deionizedoatmeal/dittokeeb/mechanical/keyboard-layout.png

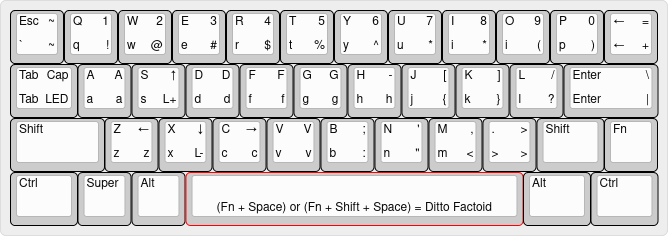
mechanical/keyboard-layout.png
