deionizedoatmeal/dittokeeb/mechanical/STLs/top_full.stl

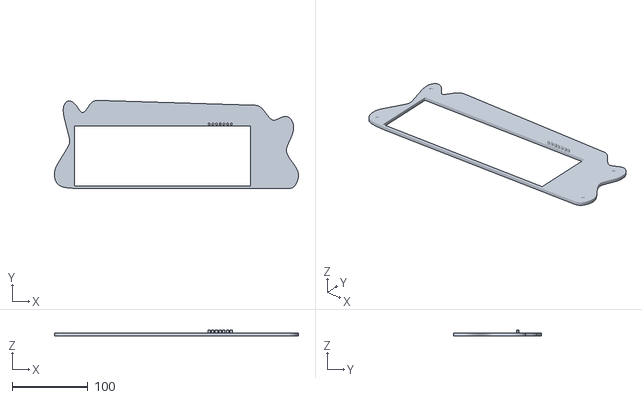
[picture p2: CAD file, 2022-06-20]
mechanical/STLs/top_full.stl
321.8 x 116.4 x 7.50
