deionizedoatmeal/dittokeeb/mechanical/STLs/case_full.stl

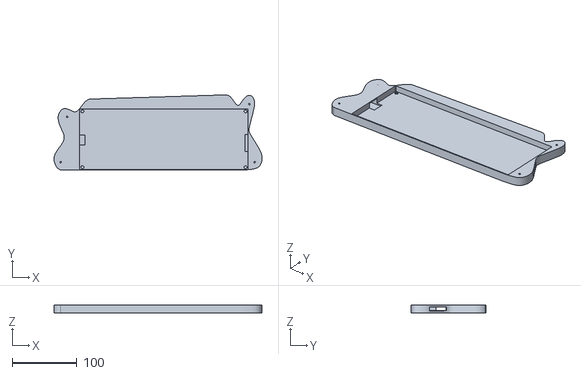
[picture p3: CAD file, 2022-06-17]
mechanical/STLs/case_full.stl
321.8 x 116.4 x 12.0
