deionizedoatmeal/dittokeeb/mechanical/STLs/top_right.stl

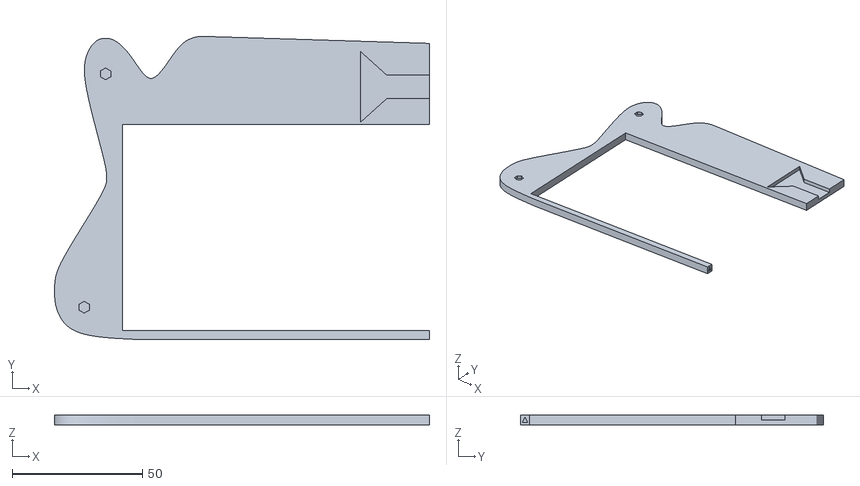
[picture p4: CAD file, 2022-06-22]
mechanical/STLs/top_right.stl
143.9 x 116.4 x 4.00
