deionizedoatmeal/dittokeeb/mechanical/STLs/top_left.stl

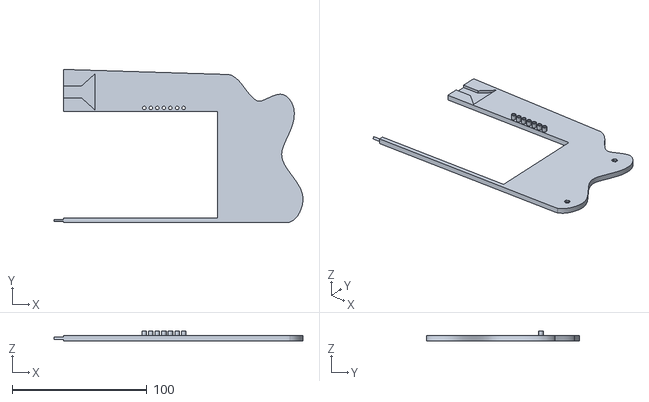
[picture p5: CAD file, 2022-06-22]
mechanical/STLs/top_left.stl
184.8 x 113.7 x 7.50
