deionizedoatmeal/dittokeeb/mechanical/STLs/ditto_key_1.75u.stl

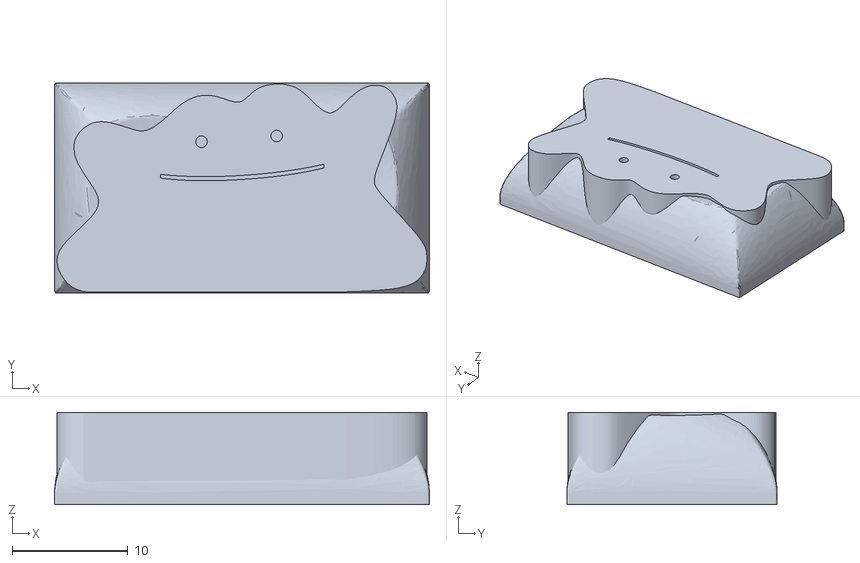
[picture p6: CAD file, 2022-06-20]
mechanical/STLs/ditto_key_1.75u.stl
32.5 x 18.2 x 8.00
