deionizedoatmeal/dittokeeb/mechanical/STLs/case_left.stl

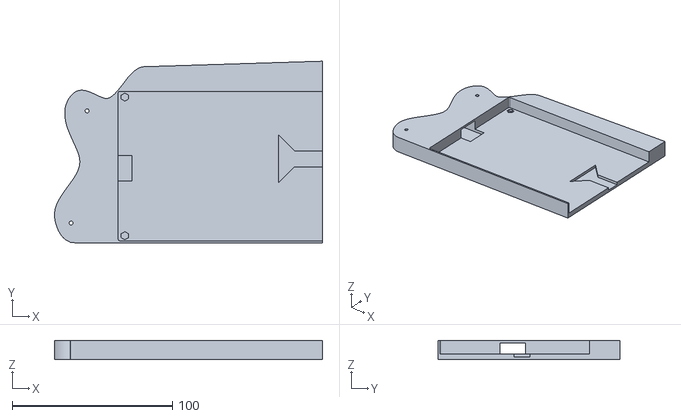
[picture p7: CAD file, 2022-06-17]
mechanical/STLs/case_left.stl
167.3 x 113.4 x 12.0
