deionizedoatmeal/dittokeeb/mechanical/STLs/case_right.stl

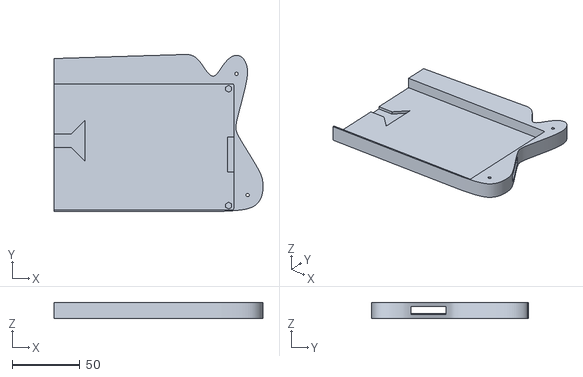
[picture p8: CAD file, 2022-06-17]
mechanical/STLs/case_right.stl
154.8 x 116.4 x 12.0
