deionizedoatmeal/dittokeeb/mechanical/STLs/plate_right.stl

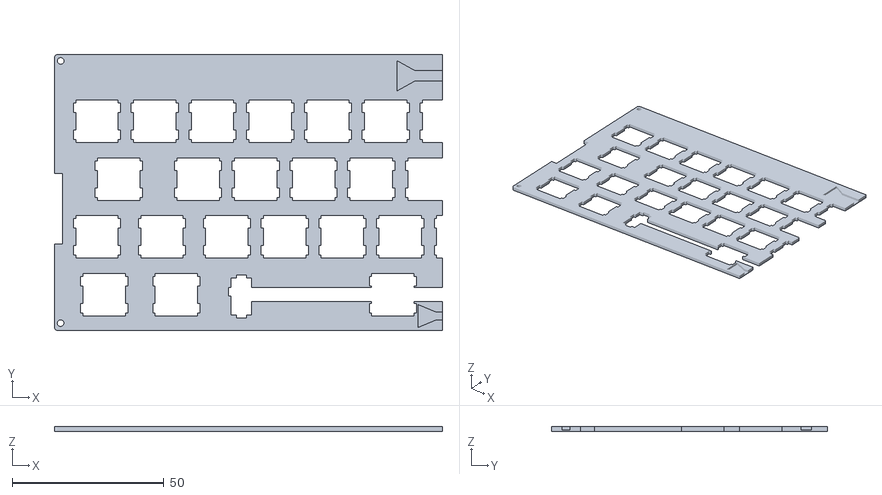
[picture p9: CAD file, 2022-06-07]
mechanical/STLs/plate_right.stl
128.0 x 91.0 x 1.50
