deionizedoatmeal/dittokeeb/mechanical/STLs/plate_left.stl

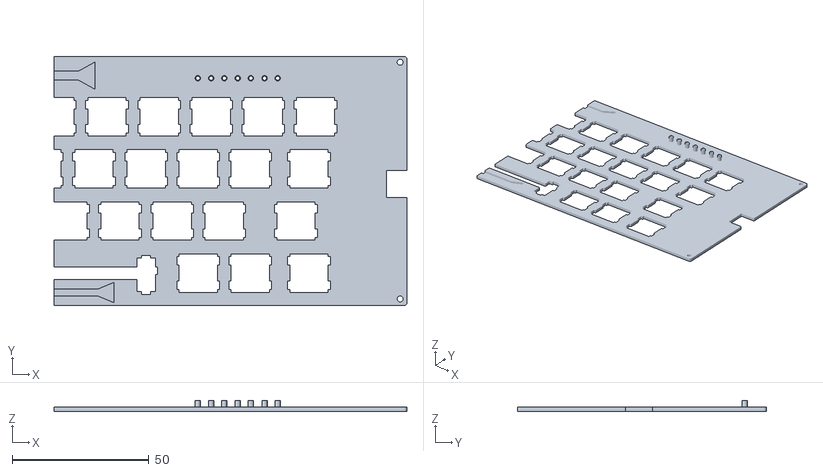
[picture p10: CAD file, 2022-06-07]
mechanical/STLs/plate_left.stl
129.0 x 91.0 x 3.90
