deionizedoatmeal/dittokeeb/mechanical/STLs/case_connector.stl

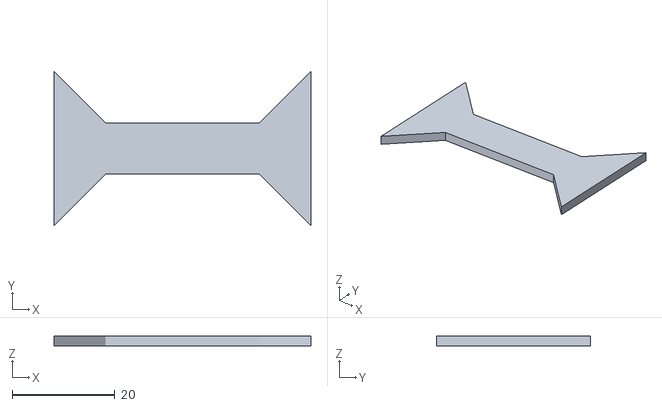
[picture p11: CAD file, 2022-06-07]
mechanical/STLs/case_connector.stl
50.0 x 30.0 x 2.00
