deionizedoatmeal/dittokeeb/mechanical/STLs/plate_connectors.stl

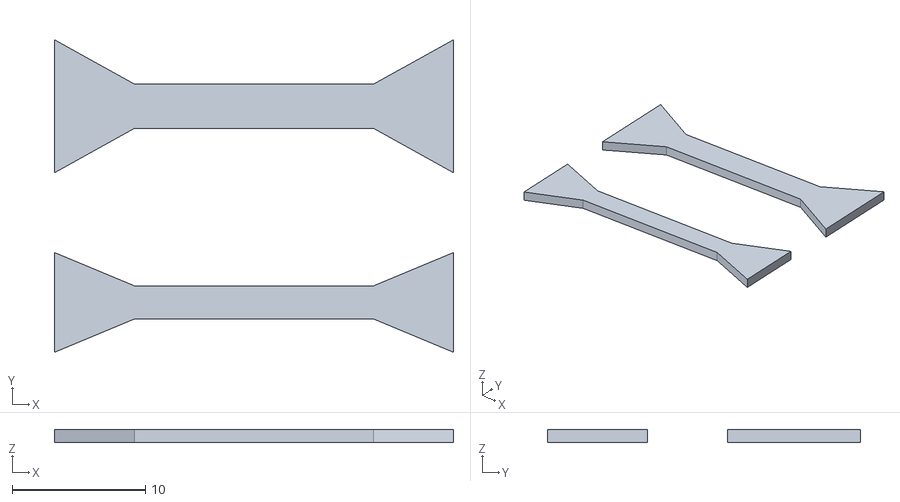
[picture p12: CAD file, 2022-06-07]
mechanical/STLs/plate_connectors.stl
30.0 x 23.5 x 1.00
