deionizedoatmeal/dittokeeb/(list of files, cad)

Other CAD files:
mechanical/STLs/top_connector.stl
