deionizedoatmeal/dittokeeb/electrical/PDFs/schematic.pdf

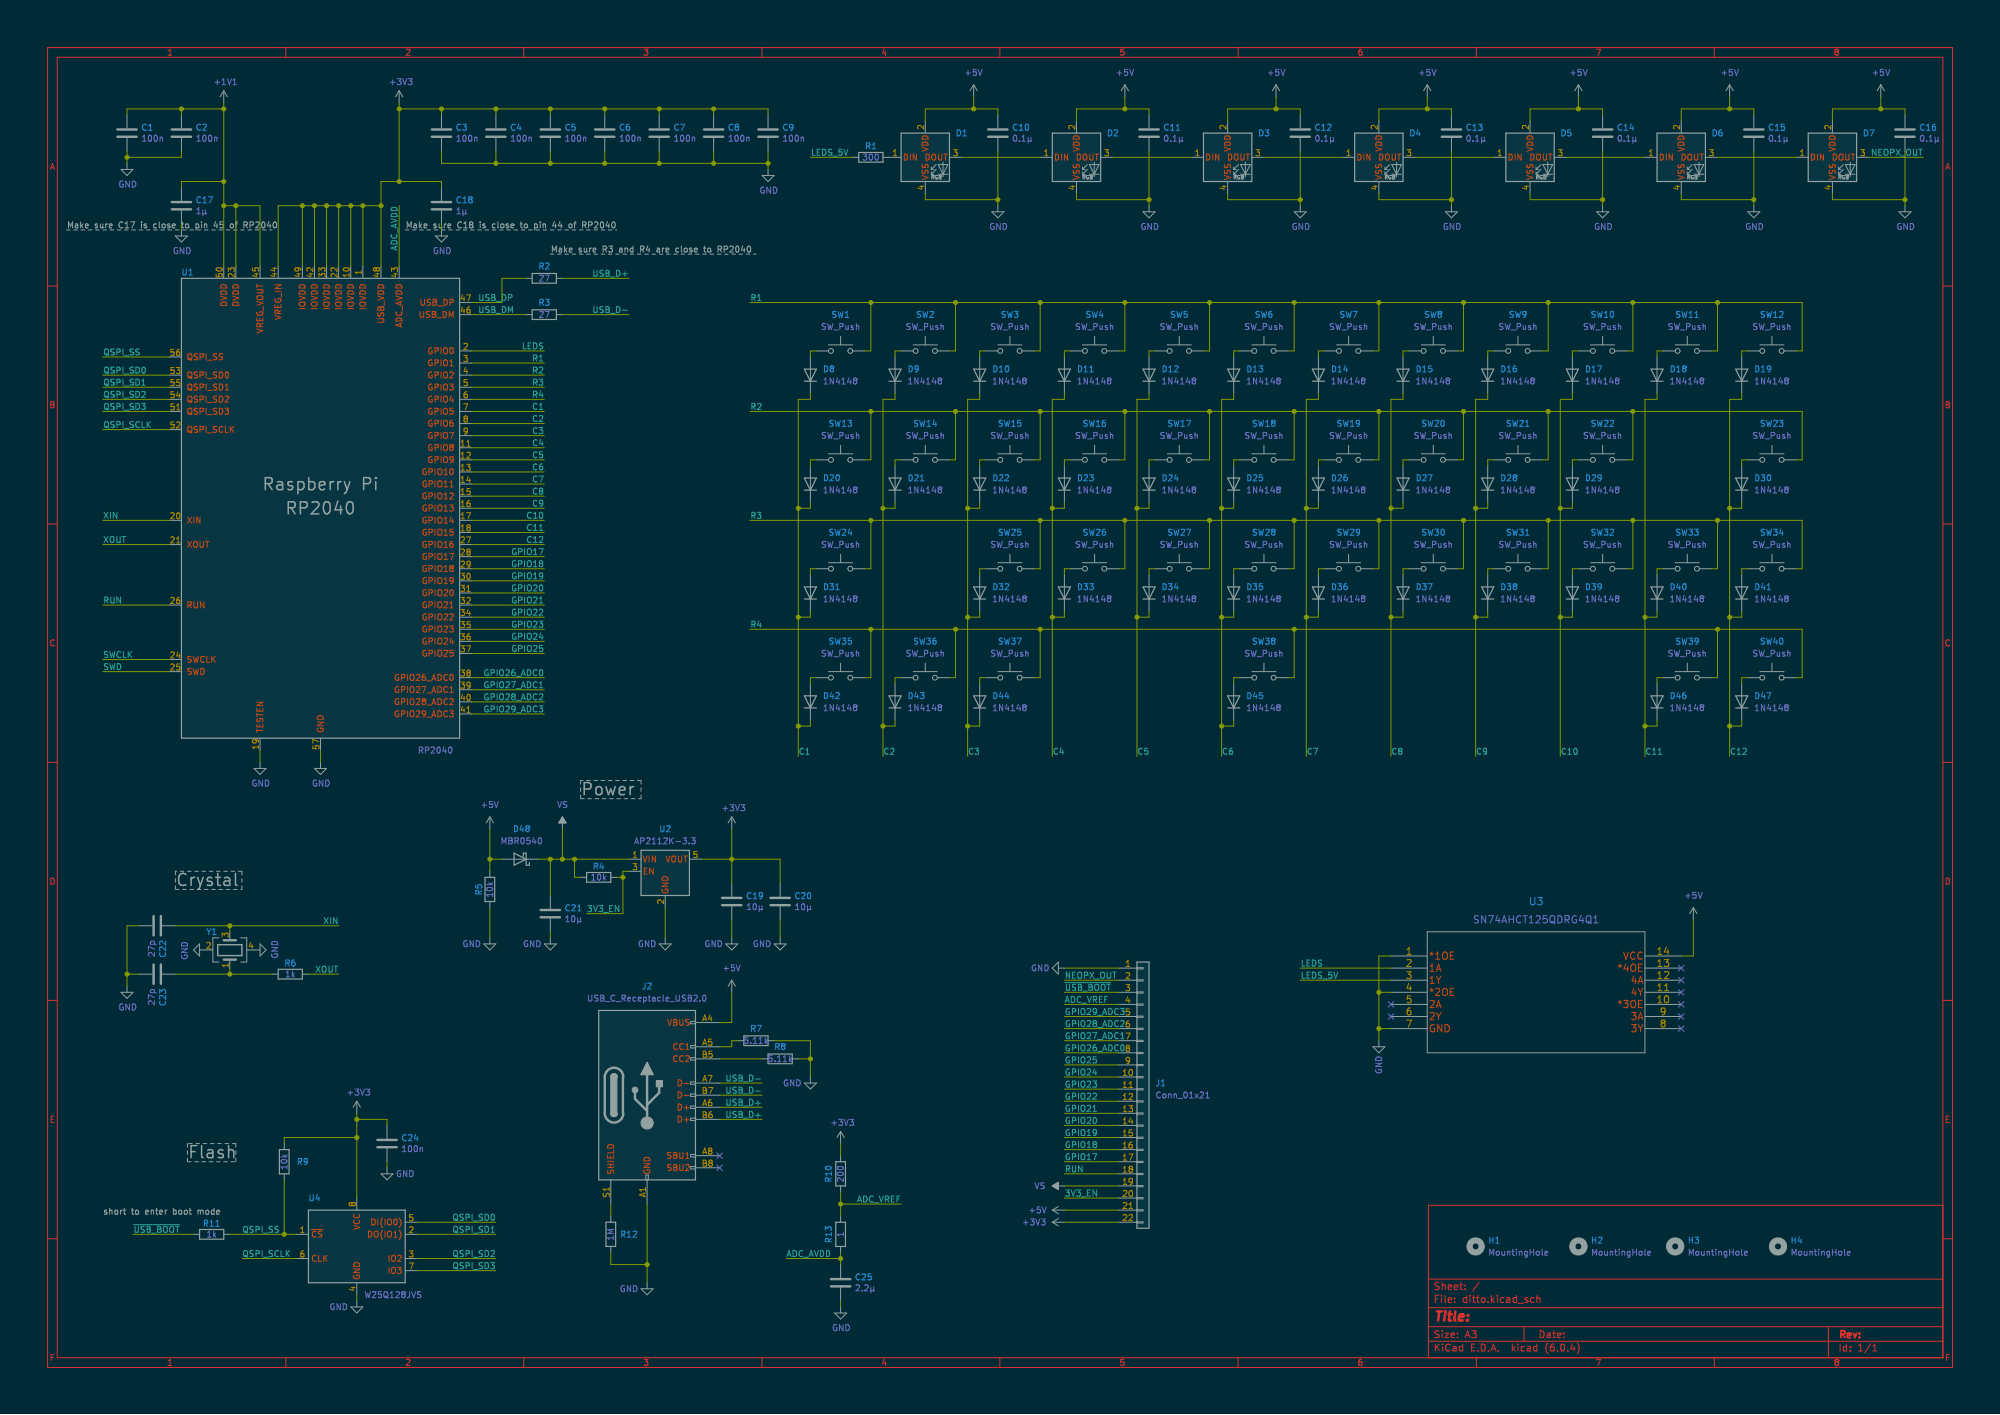
[picture p13: page 1]
