deionizedoatmeal/dittokeeb/electrical/PDFs/pcb.pdf

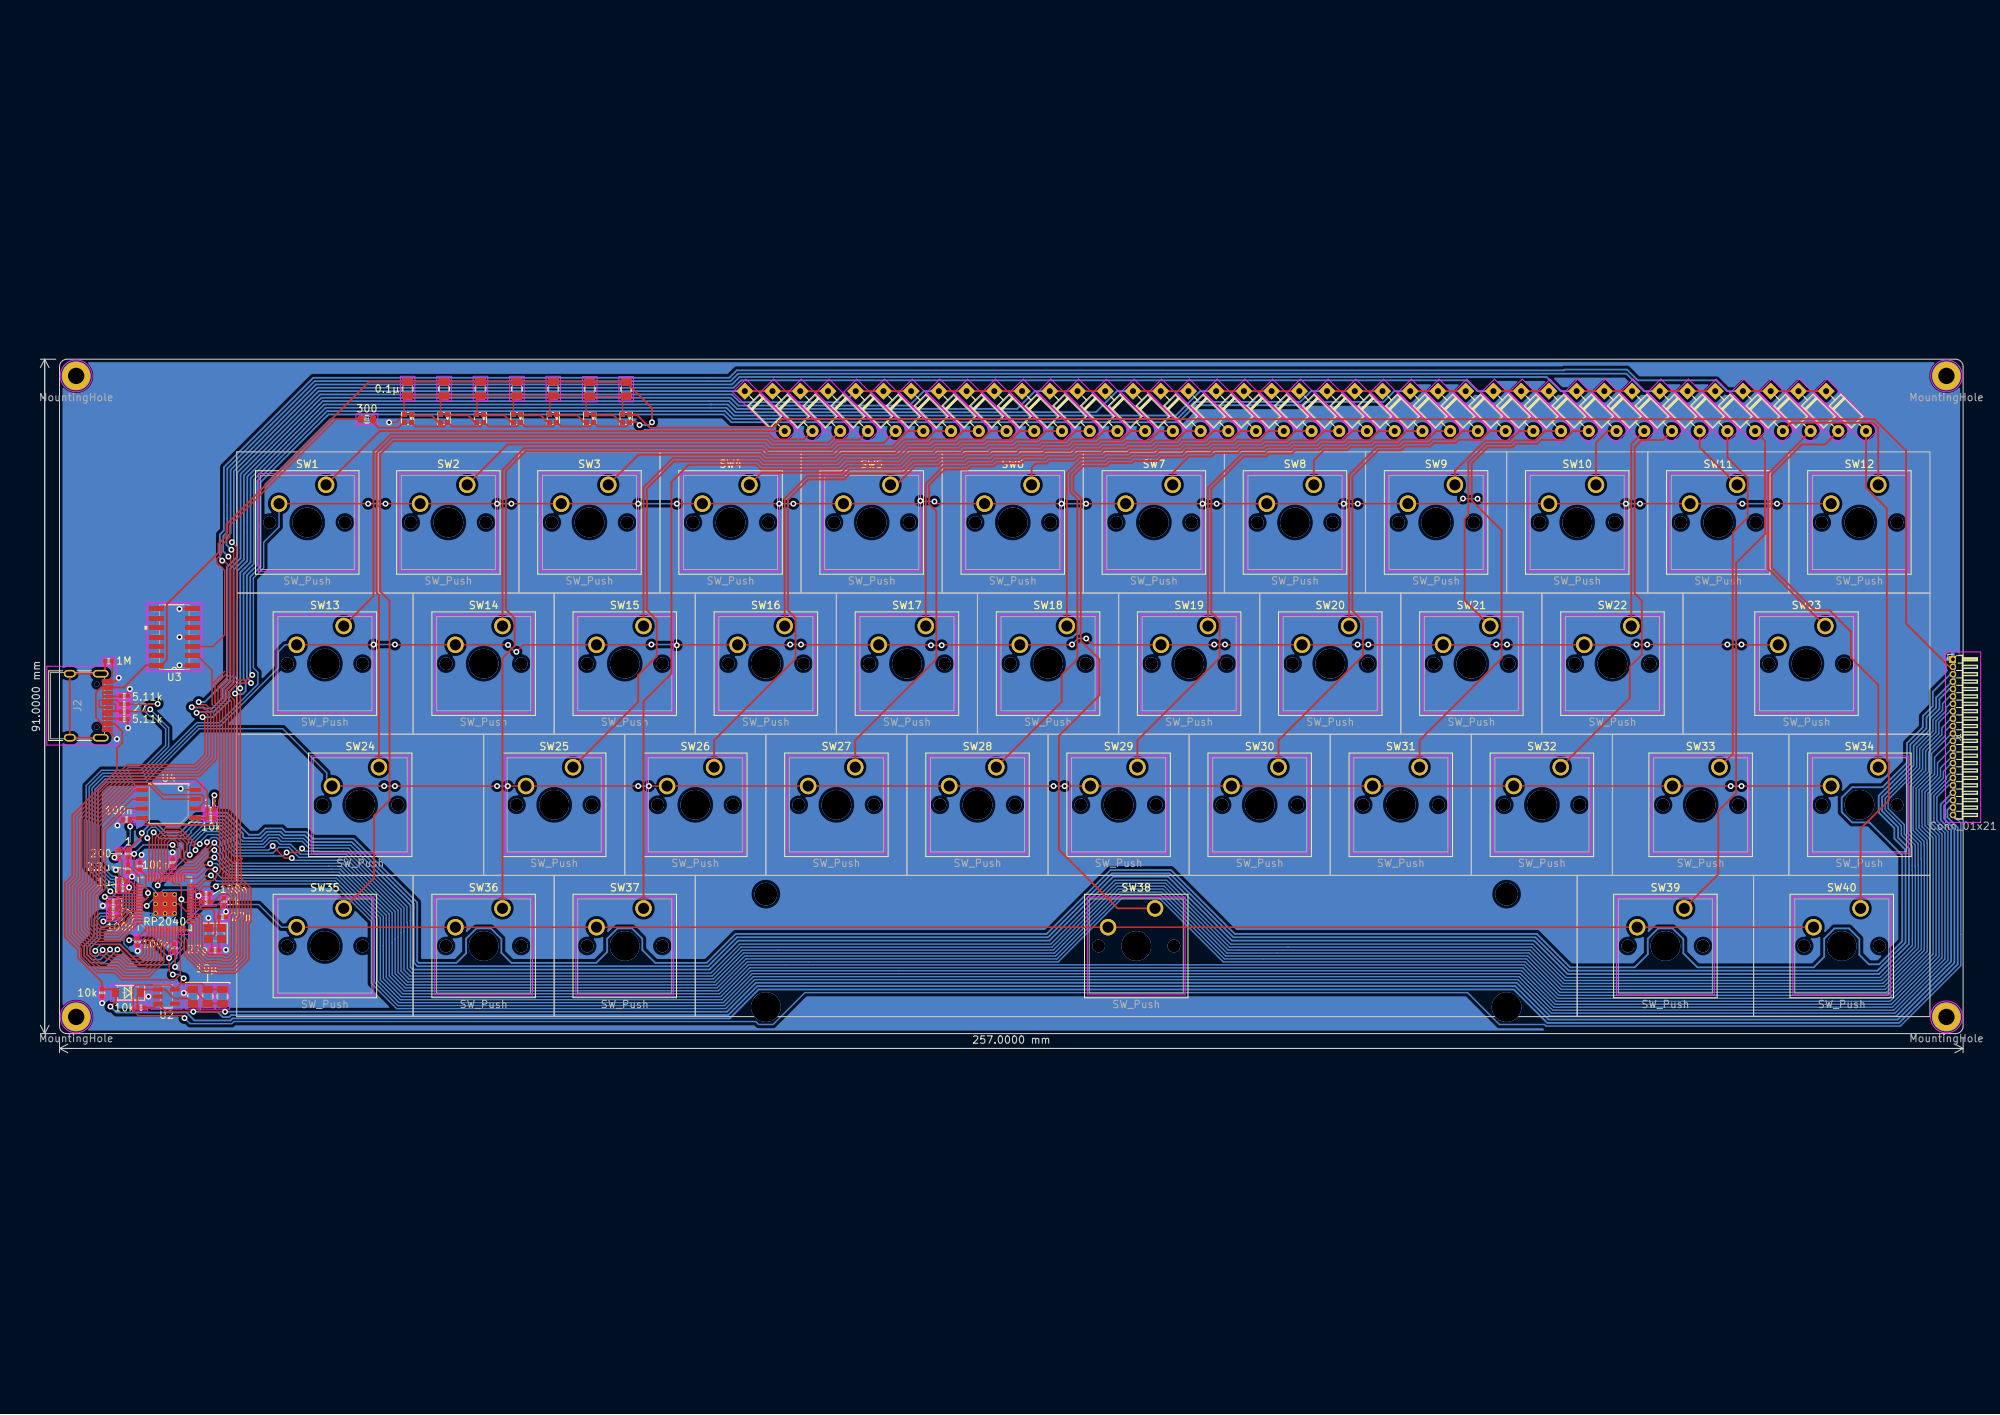
[picture p14: page 1]
