deionizedoatmeal/dittokeeb/electrical/ditto.kicad_pcb

## KiCad design electrical/ditto.kicad_pcb (2022-06-09)

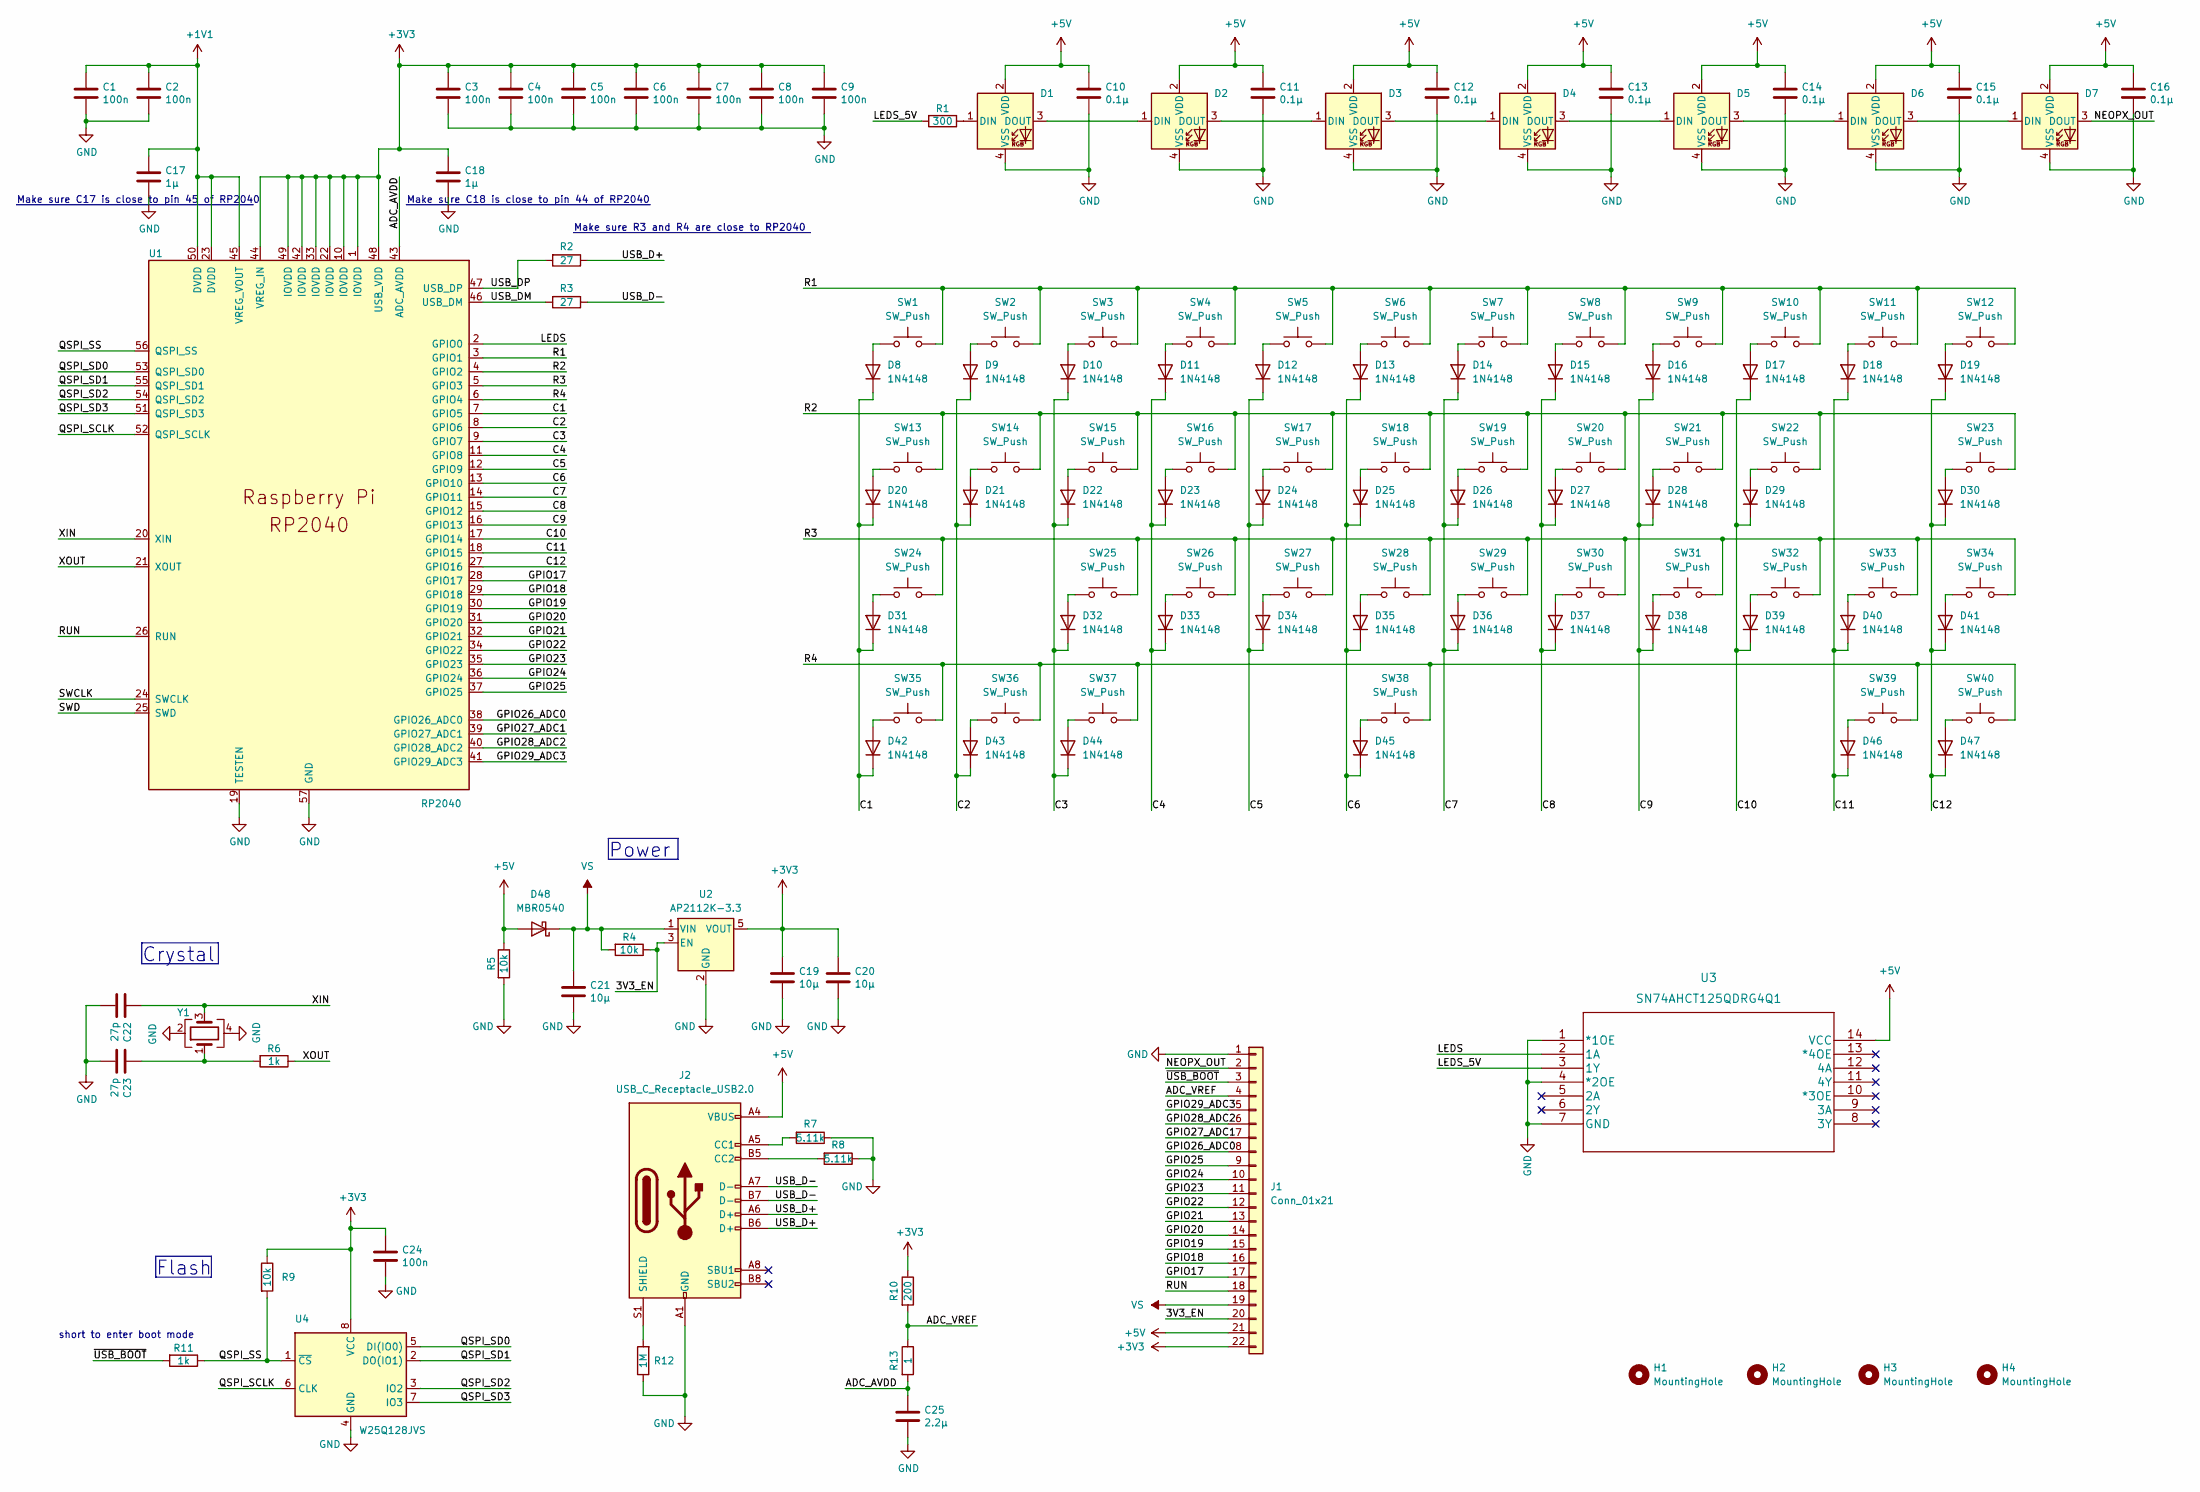
[picture p15: schematic ditto.kicad_sch]

Parts:
C1, C2, C3, C4, C5, C6, C7, C8, C9, C24: 100n; C_0402_1005Metric
C10, C11, C12, C13, C14, C15, C16: 0.1µ; C_0805_2012Metric
C17, C18: 1µ; C_0402_1005Metric
C19, C20, C21: 10µ; C_0805_2012Metric
C22, C23: 27p; C_0402_1005Metric
C25: 2.2µ; C_0402_1005Metric
D1, D2, D3, D4, D5, D6, D7: SK6805-EC
D8, D9, D10, D11, D12, D13, D14, D15, D16, D17, D18, D19, D20, D21, D22, D23, D24, D25, D26, D27, D28, D29, D30, D31, D32, D33, D34, D35, D36, D37, D38, D39, D40, D41, D42, D43, D44, D45, D46, D47: 1N4148; D_DO-35_SOD27_P7.62mm_Horizontal
D48: MBR0540; D_SOD-123
H1, H2, H3, H4: MountingHole; MountingHole_2.2mm_M2_DIN965_Pad
J1: Conn_01x21; PinHeader_1x22_P1.00mm_Horizontal
J2: USB_C_Receptacle_USB2.0; USB_C_Receptacle_HRO_TYPE-C-31-M-12
R1: 300; R_0603_1608Metric
R2, R3: 27; C_0402_1005Metric
R4, R5, R9: 10k; C_0402_1005Metric
R6, R11: 1k; C_0402_1005Metric
R7, R8: 5.11k; C_0402_1005Metric
R10: 200; C_0402_1005Metric
R12: 1M; C_0402_1005Metric
R13: 1; C_0402_1005Metric
SW1, SW2, SW3, SW4, SW5, SW6, SW7, SW8, SW9, SW10, SW11, SW12, SW14, SW15, SW16, SW17, SW18, SW19, SW20, SW21, SW22, SW25, SW26, SW27, SW28, SW29, SW30, SW31, SW32, SW34, SW36, SW37: SW_Push; SW_Cherry_MX_1.00u_PCB
SW13, SW33, SW35, SW39, SW40: SW_Push; SW_Cherry_MX_1.25u_PCB
SW23, SW24: SW_Push; SW_Cherry_MX_1.75u_PCB
SW38: SW_Push; SW_Cherry_MX_6.25u_PCB
U1: RP2040; RP2040-QFN-56
U2: AP2112K-3.3; SOT-23-5
U3: SN74AHCT125QDRG4Q1
U4: W25Q128JVS; SOIC-8_5.23x5.23mm_P1.27mm
Y1: Crystal_GND24; Crystal_SMD_3225-4Pin_3.2x2.5mm

Connections:
+1V1: C1.1, C2.1, C17.1, U1.23 (DVDD), U1.45 (VREG_VOUT), U1.50 (DVDD)
+3V3: C3.1, C4.1, C5.1, C6.1, C7.1, C8.1, C9.1, C18.1, C19.1, C20.1, C24.1, J1.22, R9.1, R10.1, U1.1 (IOVDD), U1.10 (IOVDD), U1.22 (IOVDD), U1.33 (IOVDD), U1.42 (IOVDD), U1.44 (VREG_IN), U1.48 (USB_VDD), U1.49 (IOVDD), U2.5 (VOUT), U4.8 (VCC)
+5V: C10.1, C11.1, C12.1, C13.1, C14.1, C15.1, C16.1, D1.2 (VDD), D2.2 (VDD), D3.2 (VDD), D4.2 (VDD), D5.2 (VDD), D6.2 (VDD), D7.2 (VDD), D48.2 (A), J1.21, J2.A4 (VBUS), J2.A9 (VBUS), J2.B4 (VBUS), J2.B9 (VBUS), R5.1, U3.14 (VCC)
/3V3_EN: J1.20, R4.1, U2.3 (EN)
/ADC_AVDD: C25.1, R13.2, U1.43 (ADC_AVDD)
/ADC_VREF: J1.4, R10.2, R13.1
/C1: D8.1 (K), D20.1 (K), D31.1 (K), D42.1 (K), U1.7 (GPIO5)
/C2: D9.1 (K), D21.1 (K), D43.1 (K), U1.8 (GPIO6)
/C3: D10.1 (K), D22.1 (K), D32.1 (K), D44.1 (K), U1.9 (GPIO7)
/C4: D11.1 (K), D23.1 (K), D33.1 (K), U1.11 (GPIO8)
/C5: D12.1 (K), D24.1 (K), D34.1 (K), U1.12 (GPIO9)
/C6: D13.1 (K), D25.1 (K), D35.1 (K), D45.1 (K), U1.13 (GPIO10)
/C7: D14.1 (K), D26.1 (K), D36.1 (K), U1.14 (GPIO11)
/C8: D15.1 (K), D27.1 (K), D37.1 (K), U1.15 (GPIO12)
/C9: D16.1 (K), D28.1 (K), D38.1 (K), U1.16 (GPIO13)
/C10: D17.1 (K), D29.1 (K), D39.1 (K), U1.17 (GPIO14)
/C11: D18.1 (K), D40.1 (K), D46.1 (K), U1.18 (GPIO15)
/C12: D19.1 (K), D30.1 (K), D41.1 (K), D47.1 (K), U1.27 (GPIO16)
/GPIO17: J1.17, U1.28 (GPIO17)
/GPIO18: J1.16, U1.29 (GPIO18)
/GPIO19: J1.15, U1.30 (GPIO19)
/GPIO20: J1.14, U1.31 (GPIO20)
/GPIO21: J1.13, U1.32 (GPIO21)
/GPIO22: J1.12, U1.34 (GPIO22)
/GPIO23: J1.11, U1.35 (GPIO23)
/GPIO24: J1.10, U1.36 (GPIO24)
/GPIO25: J1.9, U1.37 (GPIO25)
/GPIO26_ADC0: J1.8, U1.38 (GPIO26_ADC0)
/GPIO27_ADC1: J1.7, U1.39 (GPIO27_ADC1)
/GPIO28_ADC2: J1.6, U1.40 (GPIO28_ADC2)
/GPIO29_ADC3: J1.5, U1.41 (GPIO29_ADC3)
/LEDS: U1.2 (GPIO0), U3.2 (1A)
/LEDS_5V: R1.2, U3.3 (1Y)
/NEOPX_OUT: D7.3 (DOUT), J1.2
/QSPI_SCLK: U1.52 (QSPI_SCLK), U4.6 (CLK)
/QSPI_SD0: U1.53 (QSPI_SD0), U4.5 (DI(IO0))
/QSPI_SD1: U1.55 (QSPI_SD1), U4.2 (DO(IO1))
/QSPI_SD2: U1.54 (QSPI_SD2), U4.3 (IO2)
/QSPI_SD3: U1.51 (QSPI_SD3), U4.7 (IO3)
/QSPI_SS: R9.2, R11.1, U1.56 (QSPI_SS), U4.1 (~CS)
/R1: SW1.2, SW2.2, SW3.2, SW4.2, SW5.2, SW6.2, SW7.2, SW8.2, SW9.2, SW10.2, SW11.2, SW12.2, U1.3 (GPIO1)
/R2: SW13.2, SW14.2, SW15.2, SW16.2, SW17.2, SW18.2, SW19.2, SW20.2, SW21.2, SW22.2, SW23.2, U1.4 (GPIO2)
/R3: SW24.2, SW25.2, SW26.2, SW27.2, SW28.2, SW29.2, SW30.2, SW31.2, SW32.2, SW33.2, SW34.2, U1.5 (GPIO3)
/R4: SW35.2, SW36.2, SW37.2, SW38.2, SW39.2, SW40.2, U1.6 (GPIO4)
/RUN: J1.18, U1.26 (RUN)
/SWCLK: U1.24 (SWCLK)
/SWD: U1.25 (SWD)
/USB_D+: J2.A6 (D+), J2.B6 (D+), R2.1
/USB_D-: J2.A7 (D-), J2.B7 (D-), R3.1
/USB_DM: R3.2, U1.46 (USB_DM)
/USB_DP: R2.2, U1.47 (USB_DP)
/XIN: C22.1, U1.20 (XIN), Y1.3
/XOUT: R6.1, U1.21 (XOUT)
/~USB_BOOT: J1.3, R11.2
GND: C1.2, C2.2, C3.2, C4.2, C5.2, C6.2, C7.2, C8.2, C9.2, C10.2, C11.2, C12.2, C13.2, C14.2, C15.2, C16.2, C17.2, C18.2, C19.2, C20.2, C21.2, C22.2, C23.2, C24.2, C25.2, D1.4 (VSS), D2.4 (VSS), D3.4 (VSS), D4.4 (VSS), D5.4 (VSS), D6.4 (VSS), D7.4 (VSS), J1.1, J2.A1 (GND), J2.A12 (GND), J2.B1 (GND), J2.B12 (GND), R5.2, R7.1, R8.1, R12.1, U1.19 (TESTEN), U1.57 (GND), U2.2 (GND), U3.1 (*1OE), U3.4 (*2OE), U3.7 (GND), U4.4 (GND), Y1.2, Y1.4
unnamed: C23.1, R6.2, Y1.1
unnamed: D1.1 (DIN), R1.1
unnamed: D1.3 (DOUT), D2.1 (DIN)
unnamed: D2.3 (DOUT), D3.1 (DIN)
unnamed: D3.3 (DOUT), D4.1 (DIN)
unnamed: D4.3 (DOUT), D5.1 (DIN)
unnamed: D5.3 (DOUT), D6.1 (DIN)
unnamed: D6.3 (DOUT), D7.1 (DIN)
unnamed: D8.2 (A), SW1.1
unnamed: D9.2 (A), SW2.1
unnamed: D10.2 (A), SW3.1
unnamed: D11.2 (A), SW4.1
unnamed: D12.2 (A), SW5.1
unnamed: D13.2 (A), SW6.1
unnamed: D14.2 (A), SW7.1
unnamed: D15.2 (A), SW8.1
unnamed: D16.2 (A), SW9.1
unnamed: D17.2 (A), SW10.1
unnamed: D18.2 (A), SW11.1
unnamed: D19.2 (A), SW12.1
unnamed: D20.2 (A), SW13.1
unnamed: D21.2 (A), SW14.1
unnamed: D22.2 (A), SW15.1
unnamed: D23.2 (A), SW16.1
unnamed: D24.2 (A), SW17.1
unnamed: D25.2 (A), SW18.1
unnamed: D26.2 (A), SW19.1
unnamed: D27.2 (A), SW20.1
unnamed: D28.2 (A), SW21.1
unnamed: D29.2 (A), SW22.1
unnamed: D30.2 (A), SW23.1
unnamed: D31.2 (A), SW24.1
unnamed: D32.2 (A), SW25.1
unnamed: D33.2 (A), SW26.1
unnamed: D34.2 (A), SW27.1
unnamed: D35.2 (A), SW28.1
unnamed: D36.2 (A), SW29.1
unnamed: D37.2 (A), SW30.1
unnamed: D38.2 (A), SW31.1
unnamed: D39.2 (A), SW32.1
unnamed: D40.2 (A), SW33.1
unnamed: D41.2 (A), SW34.1
unnamed: D42.2 (A), SW35.1
unnamed: D43.2 (A), SW36.1
unnamed: D44.2 (A), SW37.1
unnamed: D45.2 (A), SW38.1
unnamed: D46.2 (A), SW39.1
unnamed: D47.2 (A), SW40.1
unnamed: J2.A5 (CC1), R7.2
unnamed: J2.B5 (CC2), R8.2
unnamed: J2.S1 (SHIELD), R12.2
VS: C21.1, D48.1 (K), J1.19, R4.2, U2.1 (VIN)

Notes on the sheet:
Crystal
Make sure C17 is close to pin 45 of RP2040
Make sure C18 is close to pin 44 of RP2040
short to enter boot mode
Make sure R3 and R4 are close to RP2040
Power
Flash

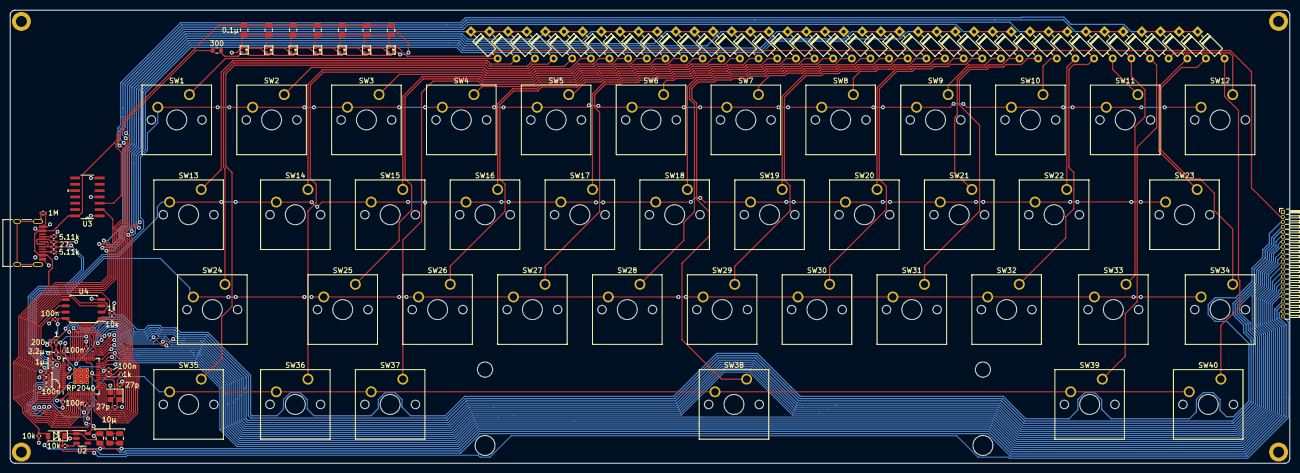
[picture p16: board ditto.kicad_pcb from above]

Board: 2 copper layers, 257.0 x 91.0 mm, 137 parts (0 on the bottom side), 105 nets.
