deionizedoatmeal/dittokeeb/(commit log)

2022-05-31 inital kicad modeling
    [ditto.kicad_pcb, ditto.kicad_sch]
2022-06-01 added logic level shifter for neopixels, gerbers, 3d file
    [ditto-B_Cu.gbl, ditto-B_Mask.gbs, ditto-B_Paste.gbp, ditto-B_Silkscreen.gbo, ditto-Edge_Cuts.gm1, ditto-F_Cu.gtl, ditto-F_Mask.gts, ditto-F_Paste.gtp]
2022-06-01 keyboard plate
2022-06-07 STLs for the case, reorganization, etc
    [case_connector.stl, case_left.stl, case_right.stl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]
2022-06-07 adjustments to case STLs
    [case_right.stl]
2022-06-08 added screw holes
    [case_left.stl, case_right.stl]
2022-06-17 adjusted a few mm on the case tolerances
    [case_full.stl, case_left.stl, case_right.stl]
2022-06-19 switched libraries
2022-06-20 minor adjustments to the top case dimensions
    [ditto_key_1.75u.stl, top_full.stl, top_left.stl, top_right.stl]
2022-06-22 adjusted mating interface on the two top halves
    [top_left.stl, top_right.stl]
2022-06-22 keystem connector
2022-06-28 adapter from 1mm headers to 2.7mm headers
    [adapter-B_Cu.gbl, adapter-B_Mask.gbs, adapter-B_Paste.gbp, adapter-B_Silkscreen.gbo, adapter-Edge_Cuts.gm1, adapter-F_Cu.gtl, adapter-F_Mask.gts, adapter-F_Paste.gtp]
